Abner0907/imx568_4_pairs_stereo/docs/variant_b_gmsl/camera_head_design.md

# Variant B — GMSL2 camera head (×8), for cable runs beyond ~30 cm

Machine-readable sources: `hardware/camera_head_gmsl/imx568_pin_net.csv` (all 132 balls → net), `camera_head_netlist.csv`, `camera_head_bom.csv`. All are generated by `hardware/tools/gen_netlist.py` from `hardware/tools/imx568_data.py`.
KiCad library: `hardware/kicad/IMX568.kicad_sym` (2 units: signals / power), `hardware/kicad/IMX568.pretty/IMX568_LGA132.kicad_mod`.

## 2.1 Power tree

```
coax centre ─PoC L (2 stages)─► VPOC 9–16 V ─TVS─┬─ TPS62160 buck ─► +3V6 (VSYS, 1 A)
                                                  │
+3V6 ─┬─ TLV62569 buck ──► +1V1_BUCK ─ TPS22918 (ON=EN_1V1, CT) ─► +1V1 ─┬─ 10 µH ─► +1V1_LIF  (VDDLIF)
      │                                                                   └─ 10 µH ─► +1V1_PLA  (VDDLPLA)
      ├─ TLV75518 LDO ──► +1V8 (always on: MAX9295A VDD18/VDDIO)
      │                    └ TPS22918 (ON=EN_1V8S) ─► +1V8_SNS (VDDMIO, OSC, pull-ups)
      ├─ LP5907-2.9 ─────► TPS22918 (ON=EN_2V9) ─► +2V9  (VDDH*)
      └─ LP5907-3.3 ─────► TPS22918 (ON=EN_3V3) ─► +3V3A (VDD33*)
```

* **Sequencing (DS 17.1):** DVDD 1.1 → OVDD 1.8 → AVDD2 2.9 → AVDD1 3.3, all within 200 ms. Power-off runs in reverse (DS 17.3). The four `EN_*` lines come from MAX9295A MFPs, and `nv_imx568.c` (`imx568_rails()`) toggles them in order with 2 ms steps. 100 kΩ pull-downs keep every sensor rail off while the serializer boots.
* **Slew ≤ 25 mV/µs (DS 17.2):** the LDOs start too fast (LP5907 ≈ 80 µs), so each rail goes through a TPS22918 with a CT capacitor. At 3.3 V the ramp must be ≥ 132 µs; target 0.5–1 ms and pick CT from the TPS22918 rise-time table. TPS22918 QOD (quick output discharge) gives a clean, ordered power-down.
* **Current (DS 11.2):** typ / max = 3.3 V 28/45 mA, 2.9 V 79/125 mA, 1.8 V 0.1/2 mA, 1.1 V 153/265 mA. The sensor draws ≈ 0.5 W typ and 0.86 W worst case. Budget about 2 W per head including the serializer (VERIFY MAX9295A current) and conversion losses.
* MAX9295A core supply: use the internal regulator or an external rail exactly as the MAX9295A datasheet specifies (VERIFY).

## 2.2 IMX568 connections

| Function | Balls | Connection (reference: DS section 19) |
|---|---|---|
| VDDLSC ×8 | A3 A10 D1 G1 H10 L1 N3 N10 | +1V1; each with 4.7 µF + 0.1 µF to its paired VSSLSC; 22 µF bulk |
| VDDLCN | B3 M3 | +1V1; 0.1 µF + 4.7 µF each; 22 µF bulk |
| VDDLCB | G4 J5 | +1V1; 0.1 µF each; 1 µF bulk |
| VDDLPL / VDDLTRG / VDDLOFD | L5 / C7 / C6 | +1V1; 4.7 µF + 0.1 µF each |
| VDDLPLD | M9 | +1V1; 0.1 µF + 1 nF |
| VDDLPLA | L7 L9 | **10 µH** from +1V1; 4.7 µF + 0.1 µF + 1 nF |
| VDDLIF | F10 K10 | **10 µH** from +1V1; 0.1 µF + 1 nF |
| VDDMIO | N9 | +1V8_SNS; 1 µF + 0.1 µF |
| VDDHCM / HAN / HDA / HCP | F4 K4 / A9 / A5 / A8 | +2V9; HCM 0.1 µF each + 22 µF; HAN 0.1 + 4.7 µF; HDA 4.7 + 0.1 µF; **HCP 3×0.1 µF + 3×1 µF** |
| VDD33PX ×4, VDD33SUB | C4 C8 J4 J8, J7 | +3V3A; 0.1 µF per PX/VSS33PX pair, 2× 22 µF bulk |
| VDD33 OFD/OFG/RST/SEL/TRG/TRX/TRY/FDB | C5 E5 E9 E4 E8 E3 E6 E7 | +3V3A; **0.1 µF + 10 µF each** |
| VCP1 → VRLTRG | A7 → D8 | net VCP1, 2× 4.7 µF to GND, no external supply |
| VCP2 → VRLSEL/TRX/OFG/TRY/FDB | A6 → D3 D4 D5 D6 D7 | net VCP2, 2× 4.7 µF to GND |
| VRMTRX, VRLWSS, VRLRST | B6, B8, D9 | GND |
| All VSS* | — | GND (single solid ground; the datasheet's 3.3 V/2.9 V/1.1 V GND labels are one plane) |
| Corner lands + C2 | A1 A12 N1 N12 C2 | GND (allowed) |
| N.C. | C11 C12 D11 D12 F2 G9 H3 H4 H9 K6–K9 K11 K12 L11 L12 | **leave open** |
| CSI-2 | H12/H11 D0, F12/F11 D1, J12/J11 D2, E12/E11 D3, G12/G11 CLK | to MAX9295A CSI inputs, 100 Ω diff; no on-board termination (receiver terminates, DS 19.5) |
| SDA / SCL | H1 / N6 | MAX9295A I²C (sensor side); 2.2 kΩ pull-ups to **+1V8_SNS** (no back-powering when off) |
| XCE | N7 | 10 kΩ to +1V8_SNS → I²C mode (DS 14.4) |
| SDO | J1 | open (I²C mode) |
| SLAMODE0/1/2 | K2 H2 L2 | 10 kΩ to GND (1st address 0x36; the driver uses common 0x1A) |
| XMASTER | L3 | 0 Ω to GND = **master** (needed for fast trigger); DNP 0 Ω to 1V8 for slave experiments |
| XCLR | J2 | 10 Ω from MAX9295A MFP; 10 kΩ pull-down |
| INCK | N8 | 10 Ω from 74.25 MHz 1.8 V oscillator (SiT8008-class, ±50 ppm; DS allows ±2 %) |
| XTRIG1 | E2 | 10 Ω from MAX9295A MFP (GMSL GPIO RX ← trigger) |
| XTRIG2 | D2 | open + test pad (DS: Hi-Z or high) |
| XVS / XHS | E1 / N5 | 10 kΩ to +1V8_SNS + test pads (outputs in master mode) |
| TOUT0 | M5 | 10 Ω → MAX9295A MFP (GPIO TX → carrier) = live exposure monitor; test pad |
| TOUT1 / TOUT2 | M7 / M6 | test pads |

**INCK gating:** the oscillator's OE follows XCLR through 10 kΩ / 10 nF (≈100 µs), with a BAT54 for fast turn-off. INCK therefore starts ≥ 1 µs after XCLR rises (DS 17.1 T5) and is Hi-Z while the sensor is in reset or off.

## 2.3 Serializer (MAX9295A) — functional hookup

| MAX9295A function | Net | Notes |
|---|---|---|
| CSI-2 input (4 data + clock), "port B" in L4T terms | CSI_D0..3_P/N, CSI_CLK_P/N | Lane swap/polarity can be fixed in the SER lane-map registers if layout demands |
| I²C (to sensor) | SNS_SDA/SCL | |
| MFP outputs | EN_1V1, EN_1V8S, EN_2V9, EN_3V3, SER_MFP_XCLR | Numbers go in the DT macros `SER_MFP_*` |
| MFP GPIO-RX | SER_MFP_XTRIG | RX ID 0 (DT `imx568,gmsl-gpio-id-trig`) |
| MFP GPIO-TX | SER_MFP_TOUT0 | TX ID 1/2 |
| SIO (coax) | GMSL_SIO via 0.1 µF AC cap → connector | SION: AC-terminate per DS |
| CFG0/CFG1 straps | — | Power-on I²C address **0x62**, coax mode, GMSL2 6 Gbps (VERIFY the resistor table) |
| Reference | crystal / clock per DS | |

Avoid MFPs that have strap or alternate functions (CFG, LOCK, ERRB, RCLKOUT, I²C pass-through) for the six GPIO roles. Check the MAX9295A pin table.

## 2.4 Coax / PoC

* Connector: 50 Ω vertical board-mount (FAKRA-Z or mini-FAKRA/HFM for compact heads).
* Size the PoC filter (typically two inductor stages + ferrite) with ADI's GMSL PoC calculator for the cable length, and check the insertion-loss/return-loss mask. 12 V nominal, 9–16 V accepted by the TPS62160 front end. TVS on VPOC.

## 2.5 Mechanical

* Board 30 × 30 mm, sensor centred, so the optical axis is the board centre. The package centre is the optical centre within ±0.075 mm (DS 7).
* M12 lens holder rated for **1/1.8″ (8.8 mm image circle)**. Holes at ±11 mm in the demo; adapt to the holder used. 4 × M2 mounting holes on a 25 mm square.
* Stereo pair: mount both heads on one rigid bracket and keep the baseline fixed. Same lens model and focus on both.
* Mono sensor with response up to ~1000 nm (DS 13): use an IR-cut filter only if needed. DS 21.5(5) warns about NIR leakage into the optical-black area with some IR-cut filters.
