Abner0907/imx568_4_pairs_stereo/hardware/kicad/camera_head_gmsl/layout_preview.png

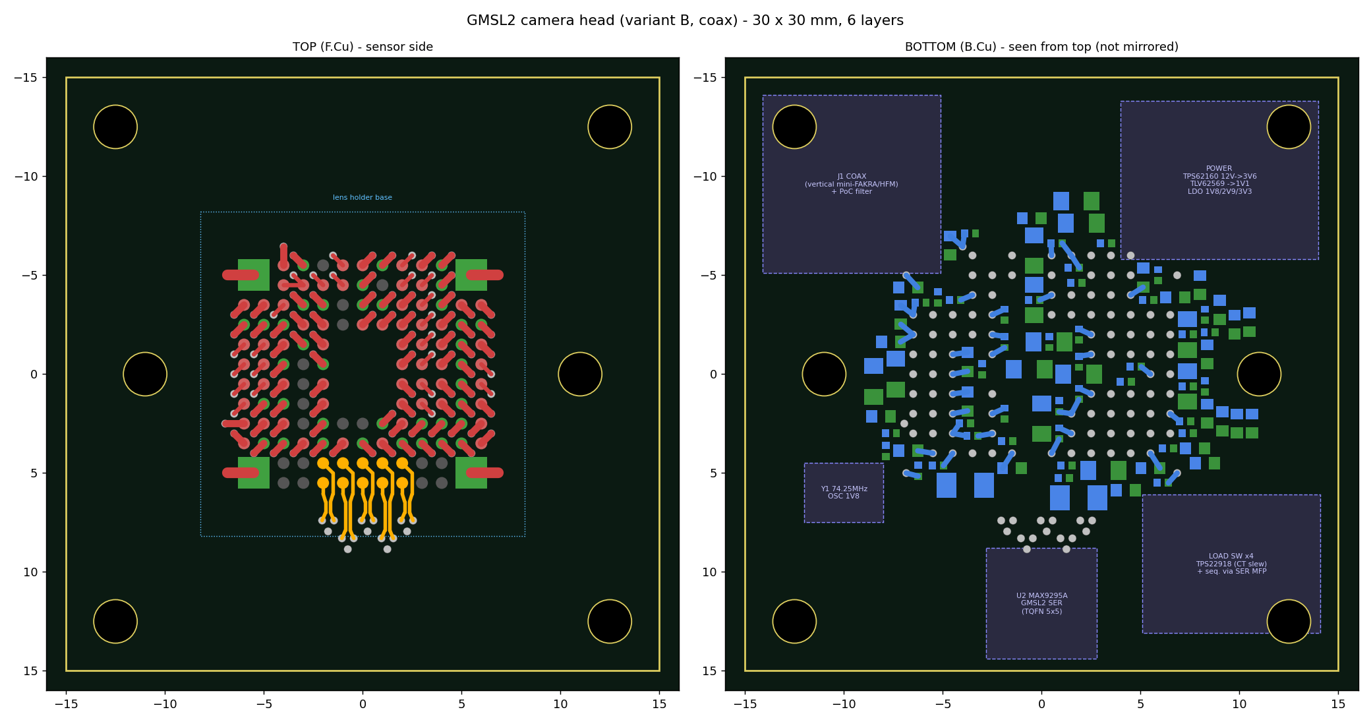
hardware/kicad/camera_head_gmsl/layout_preview.png
