Abner0907/imx568_4_pairs_stereo/hardware/camera_head_gmsl/camera_head_gmsl_bom.csv

group | part | value / note | qty (per board)
C | 0.1u 0201 X5R/X7R 6.3V+ |  | 38
C | 10u 0603 X5R/X7R 6.3V+ |  | 8
C | 1n 0201 X5R/X7R 6.3V+ |  | 3
C | 1u 0402 X5R/X7R 6.3V+ |  | 5
C | 22u 0603 X5R/X7R 6.3V+ |  | 5
C | 4.7u 0402 X5R/X7R 6.3V+ |  | 20
C | C0201 | 0.1u | 1
C | C0402 | 10n | 1
C | C0402 | 1n CT | 1
C | C0402 | 1n CT (VERIFY rise time >= V/25mV/us) | 1
C | C0402 | 2.2n CT | 2
C | C0402 (0.1 uF, 50 V) | SIO AC-coupling | 1
C | C0402 (47 nF) | SION termination AC cap per DS | 1
C | C1206 25 V | 10u | 1
D | BAT54 (SOD-523) | fast OE release | 1
D | TVS 24 V (SOD-323) |  | 1
J1 | Coax jack 50R (FAKRA-Z / mini-FAKRA / HFM) |  | 1
L | 1.0 uH 2 A |  | 1
L | 10uH 0805 >=300 mA, low DCR | VDDLIF filter | 1
L | 10uH 0805 >=300 mA, low DCR | VDDLPLA filter | 1
L | 2.2 uH 1.5 A |  | 1
L | PoC ferrite/inductor (2nd stage) |  | 1
L | PoC inductor (high-Z, e.g. 2.2-10 uH, sized w/ ADI PoC calc.) |  | 1
R | R0402 | 0R | 1
R | R0402 | 100k | 4
R | R0402 | 10R | 4
R | R0402 | 10k | 6
R | R0402 | 2k2 | 2
R | R0402 | 49.9R | 1
R | R0402 | DNP 0R | 1
T | TP | TOUT0 | 1
T | TP | TOUT1 | 1
T | TP | TOUT2 | 1
T | TP | XHS | 1
T | TP | XTRIG2 | 1
T | TP | XVS | 1
U | IMX568-AAMJ-C | LGA132 | 1
U10 | TPS22918DBV | 2.9 V switch | 1
U11 | TPS22918DBV | 3.3 V switch | 1
U2 | MAX9295A (GMSL2 SER, TQFN) | VERIFY pinout + supplies in MAX9295A DS | 1
U3 | TPS62160DSG | 12 V -> 3.6 V, 1 A buck | 1
U4 | TLV62569DBV | 3.6 V -> 1.1 V, 2 A buck | 1
U5 | TLV75518PDBV | 1.8 V 500 mA LDO (SER + sensor IO) | 1
U6 | LP5907MFX-2.9 | 2.9 V 250 mA low-noise LDO | 1
U7 | LP5907MFX-3.3 | 3.3 V 250 mA low-noise LDO | 1
U8 | TPS22918DBV | 1.1 V switch | 1
U9 | TPS22918DBV | 1.8 V switch | 1
Y | Crystal 25 MHz | for MAX9295A (per DS) | 1
Y | SiT8008B 2016 / 1.8 V OE | 74.25 MHz +-50 ppm | 1
