Abner0907/imx568_4_pairs_stereo/hardware/camera_head_gmsl/imx568_pin_net.csv

ball | pin_name | kind | net
A1 | NC_GND | NG | GND
A3 | VDDLSC | P | +1V1
A4 | VSSLSC | G | GND
A5 | VDDHDA | P | +2V9
A6 | VCP2 | A | VCP2
A7 | VCP1 | A | VCP1
A8 | VDDHCP | P | +2V9
A9 | VDDHAN | P | +2V9
A10 | VDDLSC | P | +1V1
A12 | NC_GND | NG | GND
B3 | VDDLCN | P | +1V1
B4 | VSSLCN | G | GND
B5 | VSSHDA | G | GND
B6 | VRMTRX | G | GND
B7 | VSSHCP | G | GND
B8 | VRLWSS | G | GND
B9 | VSSHAN | G | GND
B10 | VSSLSC | G | GND
C1 | VSSLSC | G | GND
C2 | NC_GND | NG | GND
C3 | VSS33PX | G | GND
C4 | VDD33PX | P | +3V3A
C5 | VDD33OFD | P | +3V3A
C6 | VDDLOFD | P | +1V1
C7 | VDDLTRG | P | +1V1
C8 | VDD33PX | P | +3V3A
C9 | VSS33PX | G | GND
C10 | VSSLIF | G | GND
C11 | NC | N | NO_CONNECT
C12 | NC | N | NO_CONNECT
D1 | VDDLSC | P | +1V1
D2 | XTRIG2 | I | SNS_XTRIG2
D3 | VRLSEL | A | VCP2
D4 | VRLTRX | A | VCP2
D5 | VRLOFG | A | VCP2
D6 | VRLTRY | A | VCP2
D7 | VRLFDB | A | VCP2
D8 | VRLTRG | A | VCP1
D9 | VRLRST | G | GND
D10 | VSSLIF | G | GND
D11 | NC | N | NO_CONNECT
D12 | NC | N | NO_CONNECT
E1 | XVS | B | SNS_XVS
E2 | XTRIG1 | I | SNS_XTRIG1
E3 | VDD33TRX | P | +3V3A
E4 | VDD33SEL | P | +3V3A
E5 | VDD33OFG | P | +3V3A
E6 | VDD33TRY | P | +3V3A
E7 | VDD33FDB | P | +3V3A
E8 | VDD33TRG | P | +3V3A
E9 | VDD33RST | P | +3V3A
E10 | VSSLIF | G | GND
E11 | DOM3 | O | CSI_D3_N
E12 | DOP3 | O | CSI_D3_P
F1 | VSSLSC | G | GND
F2 | NC | N | NO_CONNECT
F3 | VSSHCM | G | GND
F4 | VDDHCM | P | +2V9
F9 | VSS33PX | G | GND
F10 | VDDLIF | P | +1V1_LIF
F11 | DOM1 | O | CSI_D1_N
F12 | DOP1 | O | CSI_D1_P
G1 | VDDLSC | P | +1V1
G2 | VSSLSC | G | GND
G3 | VSSLCB | G | GND
G4 | VDDLCB | P | +1V1
G9 | NC | N | NO_CONNECT
G10 | VSSLSC | G | GND
G11 | DCKM | O | CSI_CLK_N
G12 | DCKP | O | CSI_CLK_P
H1 | SDA | B | SNS_SDA
H2 | SLAMODE1 | I | SNS_SLAMODE
H3 | NC | N | NO_CONNECT
H4 | NC | N | NO_CONNECT
H9 | NC | N | NO_CONNECT
H10 | VDDLSC | P | +1V1
H11 | DOM0 | O | CSI_D0_N
H12 | DOP0 | O | CSI_D0_P
J1 | SDO | O | NO_CONNECT
J2 | XCLR | I | SNS_XCLR
J3 | VSS33PX | G | GND
J4 | VDD33PX | P | +3V3A
J5 | VDDLCB | P | +1V1
J6 | VSSHAN | G | GND
J7 | VDD33SUB | P | +3V3A
J8 | VDD33PX | P | +3V3A
J9 | VSS33PX | G | GND
J10 | VSSLIF | G | GND
J11 | DOM2 | O | CSI_D2_N
J12 | DOP2 | O | CSI_D2_P
K1 | VSSLSC | G | GND
K2 | SLAMODE0 | I | SNS_SLAMODE
K3 | VSSHCM | G | GND
K4 | VDDHCM | P | +2V9
K5 | VSSLCB | G | GND
K6 | NC | N | NO_CONNECT
K7 | NC | N | NO_CONNECT
K8 | NC | N | NO_CONNECT
K9 | NC | N | NO_CONNECT
K10 | VDDLIF | P | +1V1_LIF
K11 | NC | N | NO_CONNECT
K12 | NC | N | NO_CONNECT
L1 | VDDLSC | P | +1V1
L2 | SLAMODE2 | I | SNS_SLAMODE
L3 | XMASTER | I | SNS_XMASTER
L4 | VSSLPL | G | GND
L5 | VDDLPL | P | +1V1
L6 | VSSLPLA | G | GND
L7 | VDDLPLA | P | +1V1_PLA
L8 | VSSLPLA | G | GND
L9 | VDDLPLA | P | +1V1_PLA
L10 | VSSLIF | G | GND
L11 | NC | N | NO_CONNECT
L12 | NC | N | NO_CONNECT
M3 | VDDLCN | P | +1V1
M4 | VSSLCN | G | GND
M5 | TOUT0 | O | SNS_TOUT0
M6 | TOUT2 | O | SNS_TOUT2
M7 | TOUT1 | O | SNS_TOUT1
M8 | VSSLPLD | G | GND
M9 | VDDLPLD | P | +1V1
M10 | VSSLSC | G | GND
N1 | NC_GND | NG | GND
N3 | VDDLSC | P | +1V1
N4 | VSSLSC | G | GND
N5 | XHS | B | SNS_XHS
N6 | SCL | I | SNS_SCL
N7 | XCE | I | SNS_XCE
N8 | INCK | I | SNS_INCK
N9 | VDDMIO | P | +1V8_SNS
N10 | VDDLSC | P | +1V1
N12 | NC_GND | NG | GND
