Abner0907/imx568_4_pairs_stereo/hardware/kicad/adapter_board/adapter_board.kicad_pcb

## KiCad design hardware/kicad/adapter_board/adapter_board.kicad_pcb (2026-10-09)

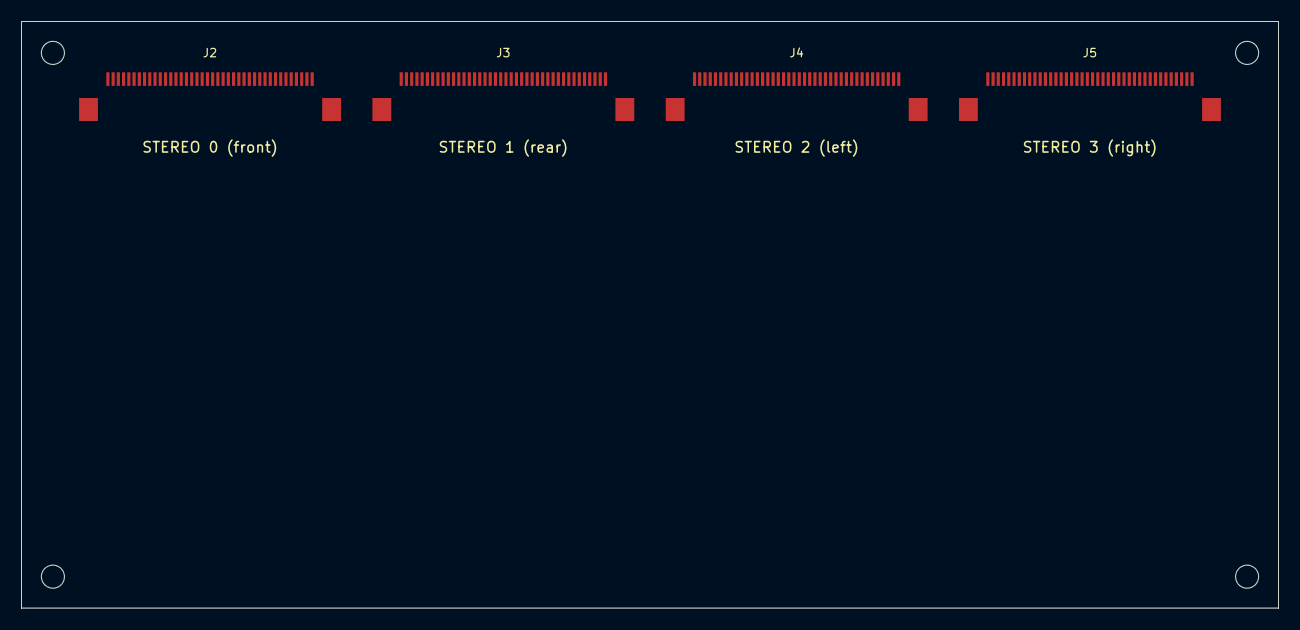
[picture p4: board adapter_board.kicad_pcb from above]

Board: 6 copper layers, 120.0 x 56.0 mm, 8 parts (0 on the bottom side), 5 nets, no tracks yet.

Parts:
H1, H2, H3, H4: M2; MountingHole_2.2mm_M2
J2, J3, J4, J5: FH12-40S-0.5SH(55); Hirose_FH12-40S-0.5SH_1x40-1MP_P0.50mm_Horizontal

Connections:
GND: J2.1, J2.4, J2.7, J2.10, J2.13, J2.16, J2.19, J2.21, J2.26, J2.29, J2.30, J2.35, J2.36, J2.37, J2.38, J2.40, J2.MP, J3.1, J3.4, J3.7, J3.10, J3.13, J3.16, J3.19, J3.21, J3.26, J3.29, J3.30, J3.35, J3.36, J3.37, J3.38, J3.40, J3.MP, J4.1, J4.4, J4.7, J4.10, J4.13, J4.16, J4.19, J4.21, J4.26, J4.29, J4.30, J4.35, J4.36, J4.37, J4.38, J4.40, J4.MP, J5.1, J5.4, J5.7, J5.10, J5.13, J5.16, J5.19, J5.21, J5.26, J5.29, J5.30, J5.35, J5.36, J5.37, J5.38, J5.40, J5.MP
S0_VIN_5V: J2.31, J2.32, J2.33, J2.34
S1_VIN_5V: J3.31, J3.32, J3.33, J3.34
S2_VIN_5V: J4.31, J4.32, J4.33, J4.34
S3_VIN_5V: J5.31, J5.32, J5.33, J5.34
