Abner0907/imx568_4_pairs_stereo/hardware/kicad/camera_head_gmsl/camera_head_gmsl.kicad_pcb

## KiCad design hardware/kicad/camera_head_gmsl/camera_head_gmsl.kicad_pcb (2026-10-09)

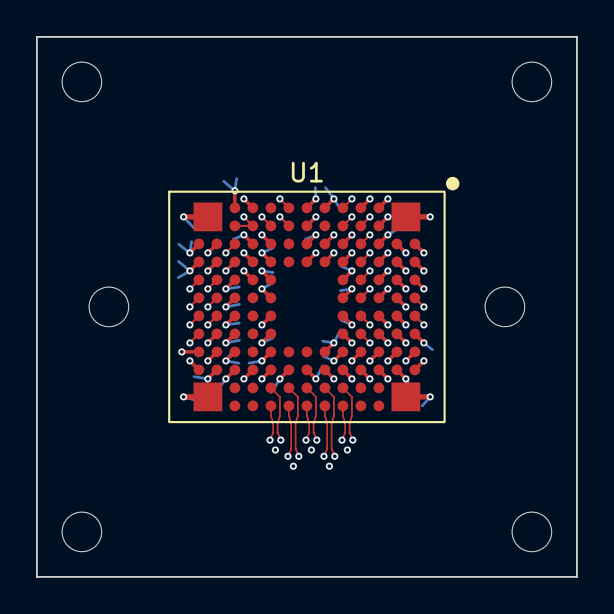
[picture p5: board camera_head_gmsl.kicad_pcb from above]

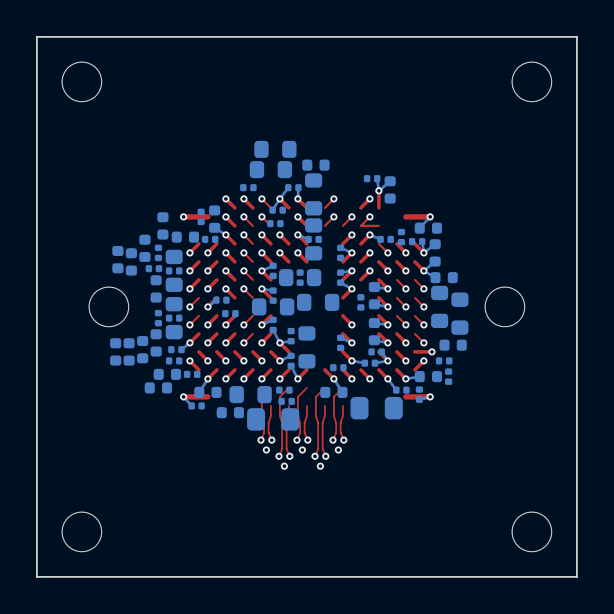
[picture p6: board camera_head_gmsl.kicad_pcb from below]

Board: 6 copper layers, 30.0 x 30.0 mm, 88 parts (81 on the bottom side), 10 nets.

Parts:
C1, C2, C3, C4, C7, C9, C11, C13, C15, C17, C19, C21, C23, C24, C26, C29, C30, C31, C32, C37, C39, C41, C43, C45, C47, C49, C51, C53, C55, C58, C59, C62, C63, C65, C68, C70, C72, C75: 0.1u; C_0201
C5, C6, C25, C52, C57: 22u; C_0603
C8, C10, C12, C14, C16, C18, C20, C22: 10u; C_0603
C27, C28, C36, C38, C40, C42, C44, C46, C48, C50, C54, C56, C61, C64, C66, C67, C76, C77, C78, C79: 4.7u; C_0402
C33, C34, C35, C60, C74: 1u; C_0402
C69, C71, C73: 1n; C_0201
H1, H2, H3, H4, H5, H6: M2; MountingHole_2.2mm_M2
L80, L81: 10uH; C_0805
U1: IMX568-AAMJ-C; IMX568_LGA132

Connections:
+1V1: C36.1, C37.1, C38.1, C39.1, C40.1, C41.1, C42.1, C43.1, C44.1, C45.1, C46.1, C47.1, C48.1, C49.1, C50.1, C51.1, C52.1, C53.1, C54.1, C55.1, C56.1, C57.1, C58.1, C59.1, C60.1, C61.1, C62.1, C63.1, C64.1, C65.1, C66.1, C70.1, C71.1, L80.1, L81.1, U1.A3, U1.A10, U1.B3, U1.C6, U1.C7, U1.D1, U1.G1, U1.G4, U1.H10, U1.J5, U1.L1, U1.L5, U1.M3, U1.M9, U1.N3, U1.N10
+1V1_LIF: C72.1, C73.1, L80.2, U1.F10, U1.K10
+1V1_PLA: C67.1, C68.1, C69.1, L81.2, U1.L7, U1.L9
+1V8_SNS: C74.1, C75.1, U1.N9
+2V9: C23.1, C24.1, C25.1, C26.1, C27.1, C28.1, C29.1, C30.1, C31.1, C32.1, C33.1, C34.1, C35.1, U1.A5, U1.A8, U1.A9, U1.F4, U1.K4
+3V3A: C1.1, C2.1, C3.1, C4.1, C5.1, C6.1, C7.1, C8.1, C9.1, C10.1, C11.1, C12.1, C13.1, C14.1, C15.1, C16.1, C17.1, C18.1, C19.1, C20.1, C21.1, C22.1, U1.C4, U1.C5, U1.C8, U1.E3, U1.E4, U1.E5, U1.E6, U1.E7, U1.E8, U1.E9, U1.J4, U1.J7, U1.J8
GND: C1.2, C2.2, C3.2, C4.2, C5.2, C6.2, C7.2, C8.2, C9.2, C10.2, C11.2, C12.2, C13.2, C14.2, C15.2, C16.2, C17.2, C18.2, C19.2, C20.2, C21.2, C22.2, C23.2, C24.2, C25.2, C26.2, C27.2, C28.2, C29.2, C30.2, C31.2, C32.2, C33.2, C34.2, C35.2, C36.2, C37.2, C38.2, C39.2, C40.2, C41.2, C42.2, C43.2, C44.2, C45.2, C46.2, C47.2, C48.2, C49.2, C50.2, C51.2, C52.2, C53.2, C54.2, C55.2, C56.2, C57.2, C58.2, C59.2, C60.2, C61.2, C62.2, C63.2, C64.2, C65.2, C66.2, C67.2, C68.2, C69.2, C70.2, C71.2, C72.2, C73.2, C74.2, C75.2, C76.2, C77.2, C78.2, C79.2, U1.A1, U1.A4, U1.A12, U1.B4, U1.B5, U1.B6, U1.B7, U1.B8, U1.B9, U1.B10, U1.C1, U1.C2, U1.C3, U1.C9, U1.C10, U1.D9, U1.D10, U1.E10, U1.F1, U1.F3, U1.F9, U1.G2, U1.G3, U1.G10, U1.J3, U1.J6, U1.J9, U1.J10, U1.K1, U1.K3, U1.K5, U1.L4, U1.L6, U1.L8, U1.L10, U1.M4, U1.M8, U1.M10, U1.N1, U1.N4, U1.N12
SNS_SLAMODE: U1.H2, U1.K2, U1.L2
VCP1: C76.1, C77.1, U1.A7, U1.D8
VCP2: C78.1, C79.1, U1.A6, U1.D3, U1.D4, U1.D5, U1.D6, U1.D7
